Maritime-Autonomy-Lab/Mariner-USV/README.md

# Mariner-USV
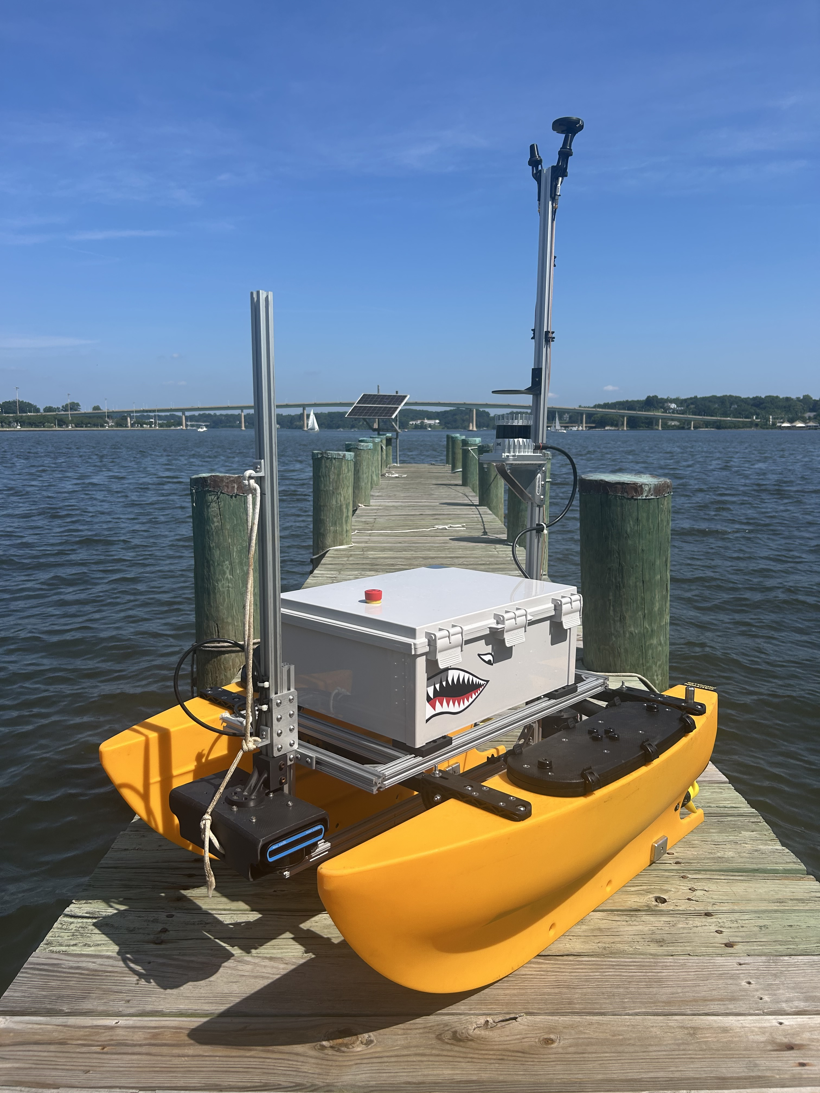
[picture p1: images/pro_pic.jpg]


This repo is for the Mariner USV. This documentation has a few important parts
- Software: link
- Hardware: link
- Docker: link
