Maritime-Autonomy-Lab/Mariner-USV/networking.md

## Networking
The vehcile has an onboard LAN, many of the sensors are on static IP addresses

- LiDAR:
- Sonar:
- DVL:
- Acoustic modem:
