Maritime-Autonomy-Lab/Mariner-USV/CAD Files/Specialty Brackets and Attachments/Insert Mount 1.step

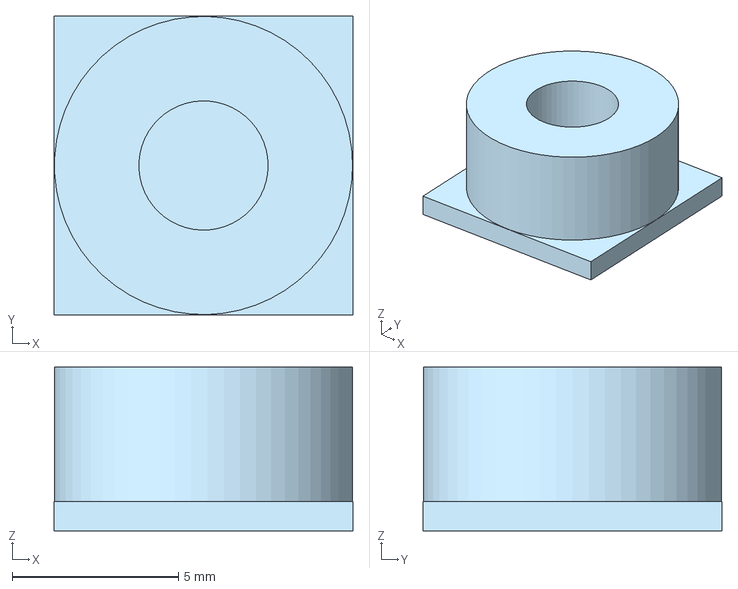
[picture p4: CAD file, 2026-05-13]
CAD Files/Specialty Brackets and Attachments/Insert Mount 1.step
8.99 x 8.99 x 4.93 mm
