Maritime-Autonomy-Lab/Mariner-USV/CAD Files/Specialty Brackets and Attachments/Pi5_Support.step

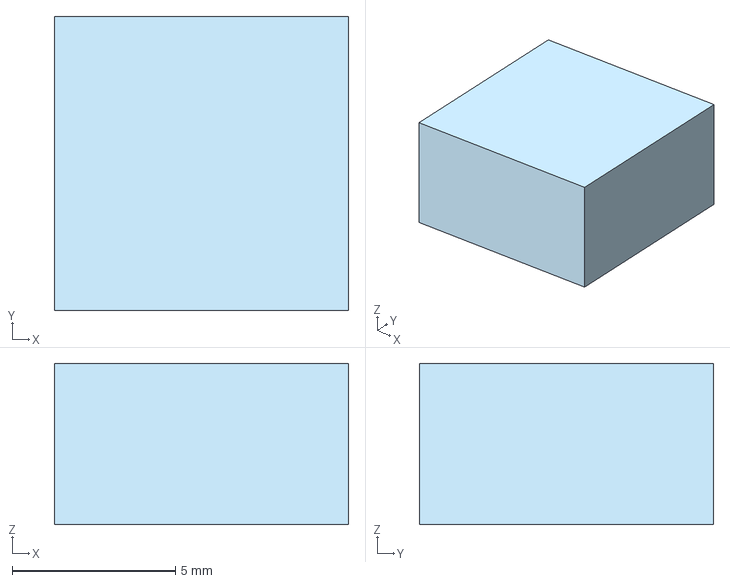
[picture p5: CAD file, 2026-05-13]
CAD Files/Specialty Brackets and Attachments/Pi5_Support.step
8.99 x 8.99 x 4.93 mm
