Maritime-Autonomy-Lab/Mariner-USV/CAD Files/Specialty Brackets and Attachments/4x4 Mariner Board.step

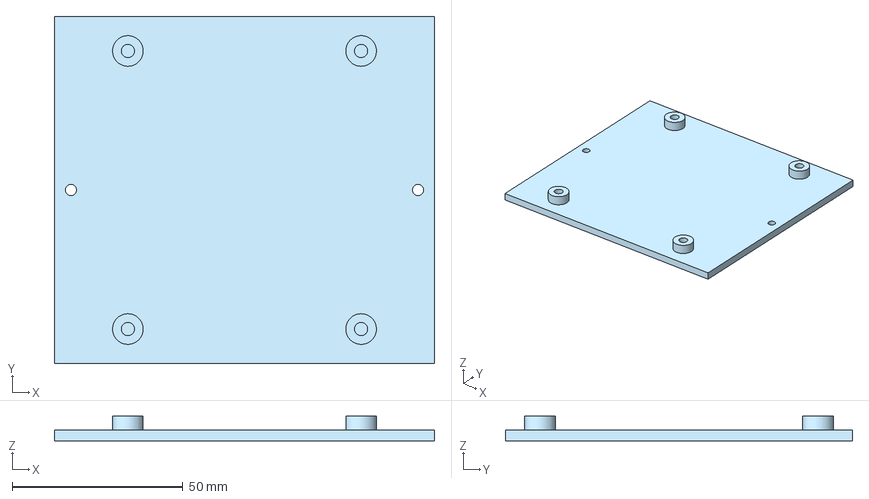
[picture p6: CAD file, 2026-05-13]
CAD Files/Specialty Brackets and Attachments/4x4 Mariner Board.step
111.2 x 101.6 x 7.21 mm
