Maritime-Autonomy-Lab/Mariner-USV/(list of files, cad)

Other CAD files:
CAD Files/Acrylic Plates/box tray_middle.dwg
CAD Files/Acrylic Plates/box tray_base.dwg
CAD Files/Acrylic Plates/box tray_top.dwg
CAD Files/Acrylic Plates/box tray_base.ipt
CAD Files/Acrylic Plates/box tray_middle.ipt
CAD Files/Acrylic Plates/box tray_top.ipt
CAD Files/Assemblies/8020_frame/47065T736_Silver Gusset Bracket (1).ipt
CAD Files/Assemblies/8020_frame/47065T736_Silver Gusset Bracket.ipt
CAD Files/Assemblies/8020_frame/Payload Bottom.ipt
CAD Files/Assemblies/8020_frame/Payload Front.ipt
CAD Files/Assemblies/8020_frame/Payload Rear.ipt
CAD Files/Assemblies/8020_frame/T Slot Long.ipt
CAD Files/Assemblies/8020_frame/T Slot Wide.ipt
CAD Files/Assemblies/8020_frame/T-Slot Inner.ipt
CAD Files/Assemblies/8020_frame/frame.iam
CAD Files/Assemblies/8020_frame/sonar pole.ipt
CAD Files/Assemblies/Box_Tray_Assembly.iam
CAD Files/Assemblies/Housing_Box/BASE^WQ-76L-01.ipt
CAD Files/Assemblies/Housing_Box/FRONT^WQ-76L-01_default.ipt
CAD Files/Assemblies/Housing_Box/LOOP^WQ-76L-01.ipt
CAD Files/Assemblies/Housing_Box/PIN^WQ-76L-01.ipt
CAD Files/Assemblies/Housing_Box/WQ-76B_WQ-76B-02.ipt
CAD Files/Assemblies/Housing_Box/WQ-76L-01_DEFAULT.iam
CAD Files/Assemblies/Housing_Box/WQ-76S_WQ-76S-02.iam
CAD Files/Assemblies/Housing_Box/WQ-PIN-03.ipt
CAD Files/Base Brackets/3x3_bracket.ipt
CAD Files/Base Brackets/4x2_bracket.ipt
CAD Files/Base Brackets/4x4_bracket.ipt
CAD Files/Base Brackets/5x4_bracket.ipt
CAD Files/Specialty Brackets and Attachments/Battery_holder.ipt
CAD Files/Specialty Brackets and Attachments/radio bracket.iam
